waner667/esp32-c6-gimbal-tracker/mw_360base_author.png

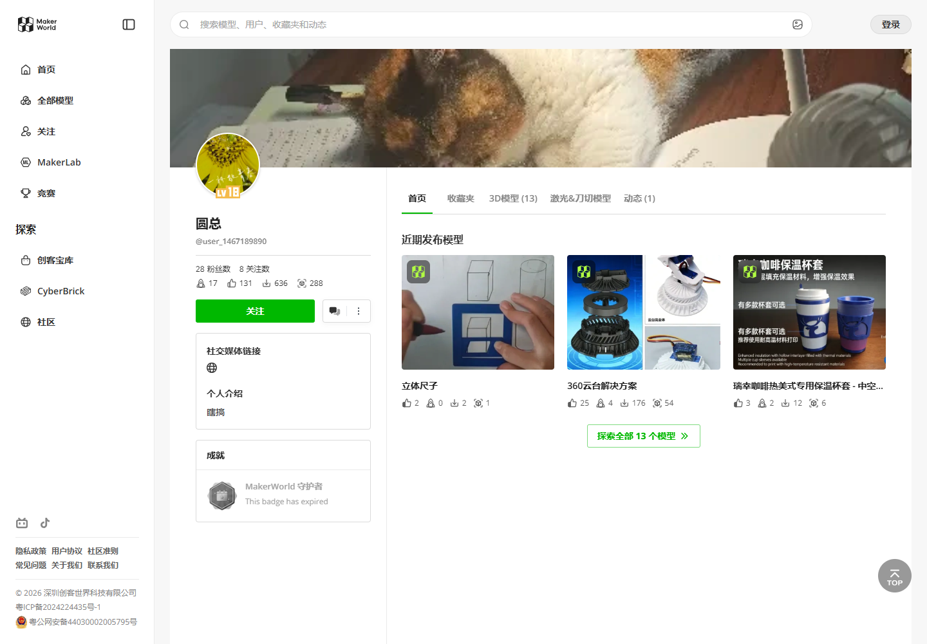
mw_360base_author.png
