waner667/esp32-c6-gimbal-tracker/mw_360base_page.png

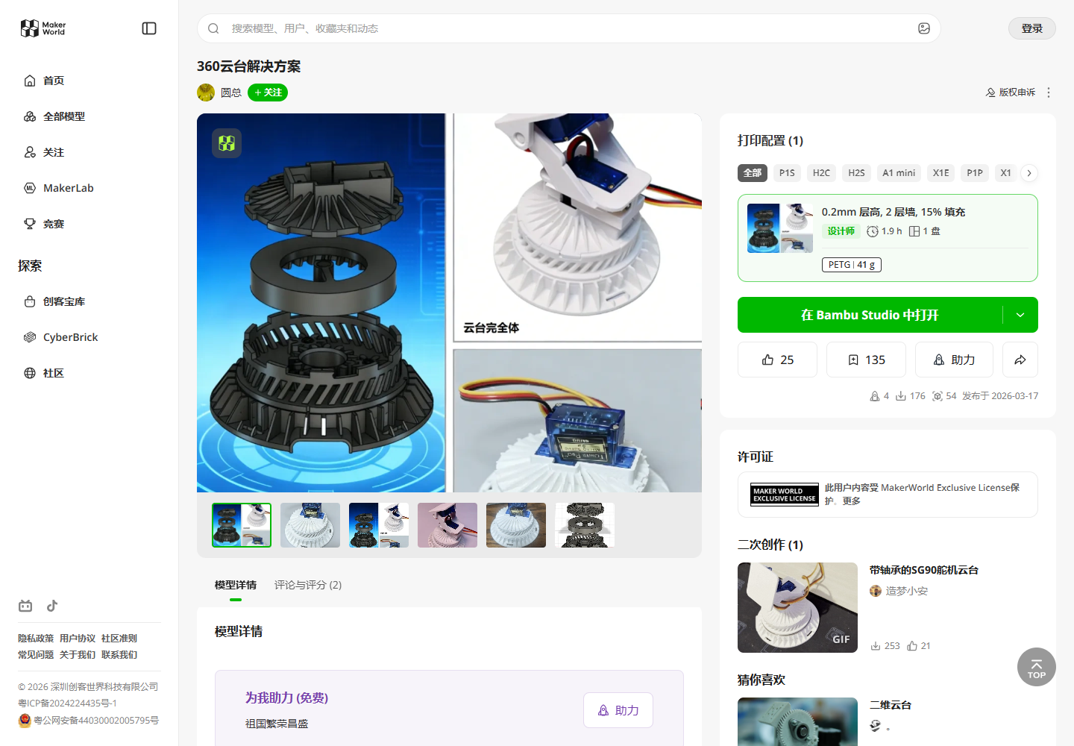
mw_360base_page.png
