waner667/esp32-c6-gimbal-tracker/servo-status.md

# 舵机线状态总览（2026-10-20 18:00 收尾）

> 本文是舵机这条线的"存档点"：做到哪了、卡在哪、怎么恢复、踩过什么坑，都在这一页。
> 实时细节以 `gimbal_firmware.ino` / `wiring-guide.md` 为准；本文管状态和历史。

---

## 一句话状态

**固件侧 100% 全通（全部实测过），硬件侧唯一卡点是降压模块烧毁。**
换一个能输出 5.0V 的电源，按第 3 节 checklist 走，10 分钟收尾。

---

## 1. ✅ 已验证 OK 的（都是实测，不是推断）

| 项 | 证据 |
|---|---|
| Arduino 环境 | esp32 core 3.3.12 + ESP32Servo 装好，编译/烧录/串口全通 |
| 固件烧录 | RST 后串口打印 `READY pan=GPIO10 tilt=GPIO11 attach=0,0` |
| PWM 挂载 | `attach=0,0` → ESP32Servo 正常挂上 LEDC 通道，PWM 确实从 GPIO10/11 输出 |
| 命令链路 | 发 `P120,T90` → 回显 `OK pan=120 tilt=90`（回显是这次专门加的，之前是哑巴） |
| 舵机本体 | 3.3V 排针碰一下橙线，舵机猛转 → SG90 是好的 |
| 供电 | 万用表测舵机红↔棕 ≈5V ✓（模块烧毁前测的） |
| 共地 | 蜂鸣档测 C6 GND ↔ 舵机 GND，通 ✓ |
| 固件功能 | 软件限位（pan 10~170 / tilt 20~110）、平滑插值（1.5°/步）、上电归中都在 |
| 遥控协议 | 三协议自动识别代码就绪（i-BUS/CRSF/SBUS @ GPIO6），**待通电后实测 `RC LOCK`** |

## 2. 🔴 当前唯一卡点：降压模块烧毁（16:55 事故）

- **经过**：12V 可调电源电压开得太大，超过降压模块输入额定，模块烧毁
- **影响**：舵机失去 5V 动力电源（信号、共地、C6 都好的）
- **C6 无损**：C6 与降压模块世界之间只连了一根共地线，没有 12V 倒灌路径；USB 一度无响应是线缆接触问题，换线后恢复
- **恢复供电三选一**：
  1. 修/换降压模块（⚠️ 可调电源**先拧回 12V** 再接模块，这次烧就是输入超额定）
  2. 手机 5V 充电头（5V/1A 以上）直供，调试完全够用
  3. 任何稳压 5V 电源

## 3. 恢复运行 Checklist（电源就绪后照做，约 10 分钟）

1. **先测压**：万用表直流档测新电源输出 = **准 5.0V**，才准碰舵机红线
2. **接线**（详见 `wiring-guide.md`）：
   - 舵机红线 → 5V+，棕线 → GND
   - **共地**：电源 GND → C6 的 GND 排针（唯一不能省的线）
   - 橙线：pan → **GPIO10**，tilt → **GPIO11**
3. C6 插 USB（USB-to-UART 那个口），串口发 `P120,T90`
4. 判读：

| 现象 | 结论 |
|---|---|
| pan 平滑转到 120° | 🎉 收工，接 tilt 双轴联调 |
| 不动 | 橙线直碰 C6 的 GPIO10 排针（绕过面包板）：转=面包板孔虚/线断；不转=告诉我，手写 LEDC PWM 替换 ESP32Servo |

## 4. 排障时间线（今天真实走过的路，含教训）

| 时间 | 事件 | 教训 |
|---|---|---|
| 早 | 回显 `pan=0 tilt=1079900208` | `panTgt/tiltTgt` 声明成 float 却用 `%d` 打印，C6 是 RISC-V 架构，float 参数进浮点寄存器，`%d` 读到残留乱值 → 角度本来就是整数，目标值用 `int` |
| 11:19 | **舵机不动破案**：pan 橙线一直插在 **GPIO13**（C6 原生 USB 的 DM/DP 数据脚），固件从 GPIO10 输出，信号断在中间 | **固件回显全正常 ≠ 线接对了**。这是今天最大的坑，极具伪装性 |
| 11:21 | 面包板只剩一列（4/5/6/7/8/10/11/12/13/1），线序定案 **GPIO10(pan)/GPIO11(tilt)** | 4/5/8/9/15 是 strapping 脚、12/13 是 USB 脚、1 是晶振脚，都碰不得 |
| 16:14~16:31 | 万用表两测（5V ✓、共地 ✓）→ 3.3V 触碰（舵机本体好）→ attach=0,0（软件全清） | 隔离法逐层排除，每一步都有明确判据，不猜 |
| 16:55 | **降压模块烧毁** | 可调电源先调压再接负载；调压用万用表，不信目测 |
| 18:06 | （摄像头线）按 0 切内置摄像头画面冻住，已修 `camera_test.py` | 切换采集设备先 release 旧的，否则双设备抢占把 `read()` 阻塞死 |

## 5. 防呆要点（血泪浓缩）

1. **固件回显全正常 ≠ 硬件接对**——GPIO13 案例：软件说 `OK pan=120` 说得漂漂亮亮，信号压根没出 C6
2. **12V 可调电源：先调压，后接线**——这次模块就是这么烧的
3. **GPIO12/13 是 USB 数据脚，任何线不往上插**；4/5/8/9/15 是 strapping 脚，接了可能开不了机
4. **共地是唯一不能省的线**，漏了它舵机完全不理会你
5. **万用表三步走**（舵机不动时）：红↔棕 5V → 蜂鸣档共地 → 橙↔棕发命令有跳动，比肉眼排查十圈都快

## 6. 文件索引

| 文件 | 内容 |
|---|---|
| `gimbal_firmware/gimbal_firmware.ino` | 固件，PAN=GPIO10 / TILT=GPIO11，遥控 RX=GPIO6，带回显和 attach 状态 |
| `wiring-guide.md` | 施工级接线文档（总览图/6 步顺序/故障速查/遥控协议对照） |
| `gimbal_firmware/servo_test.py` | PC 端测试脚本，`python servo_test.py COM10` |
| `tracker.py` | 闭环追踪（`--port COM10`），电源恢复后直接跑它看追人 |
| `README.md` | 项目总索引（状态/文档分工/运行方式） |
| `gimbal-plan.md` 第 11 节 | 项目总 checkpoint |
| `.workbuddy/memory/2026-10-20.md` | 当天完整流水日志 |
