waner667/esp32-c6-gimbal-tracker/docs/architecture-closed-loop.png

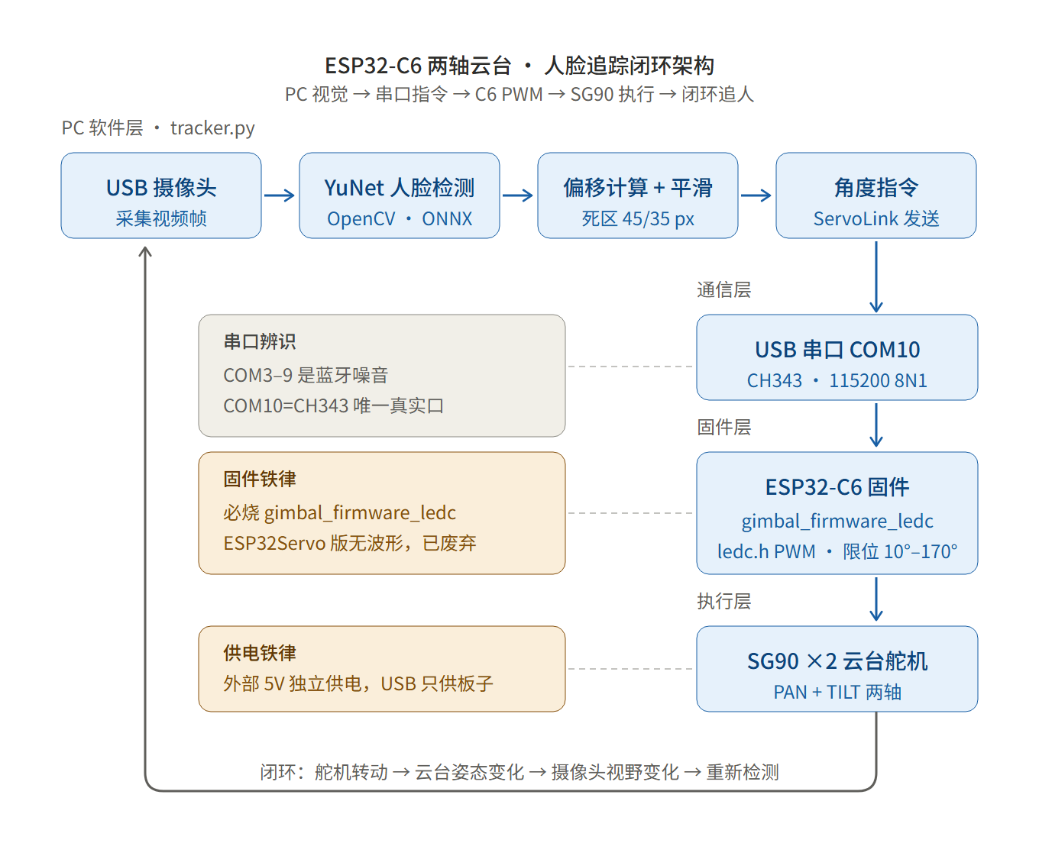
docs/architecture-closed-loop.png
