waner667/esp32-c6-gimbal-tracker/docs/pc-software-toolchain.png

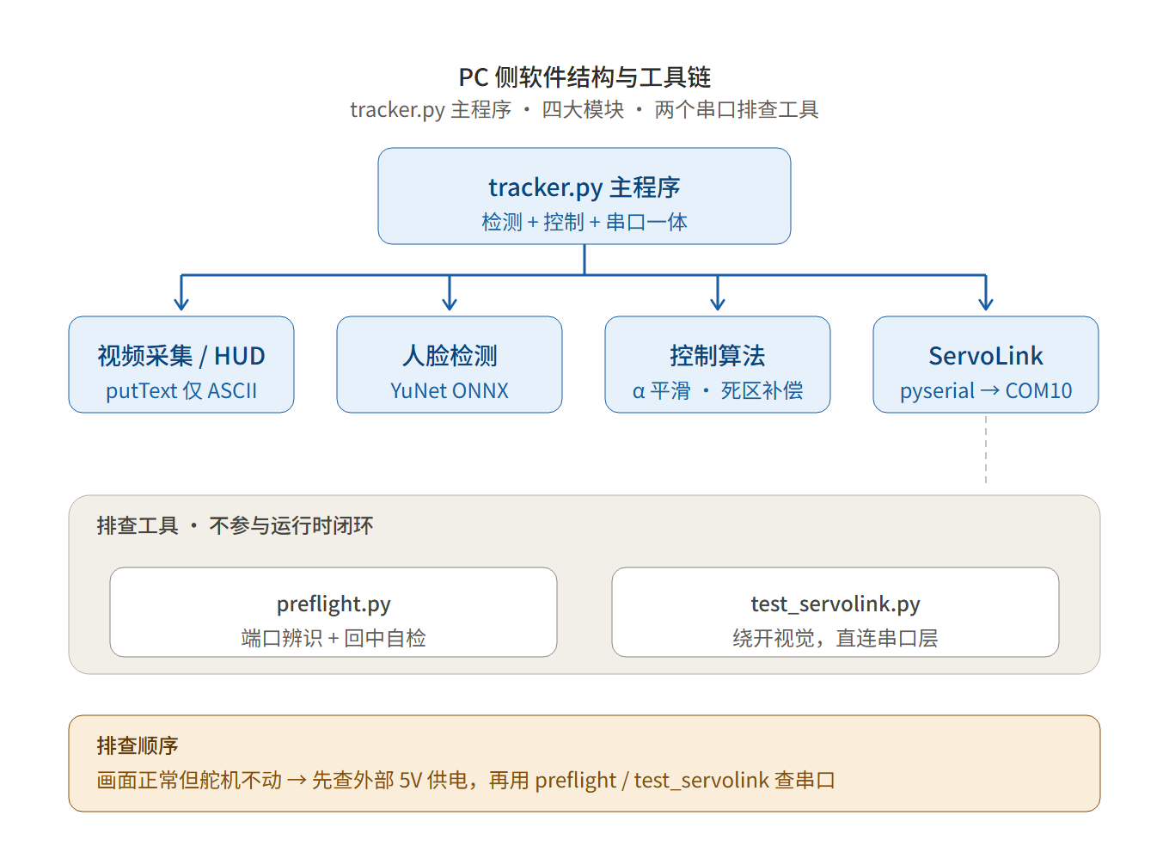
docs/pc-software-toolchain.png
