waner667/esp32-c6-gimbal-tracker/face_snapshot.png

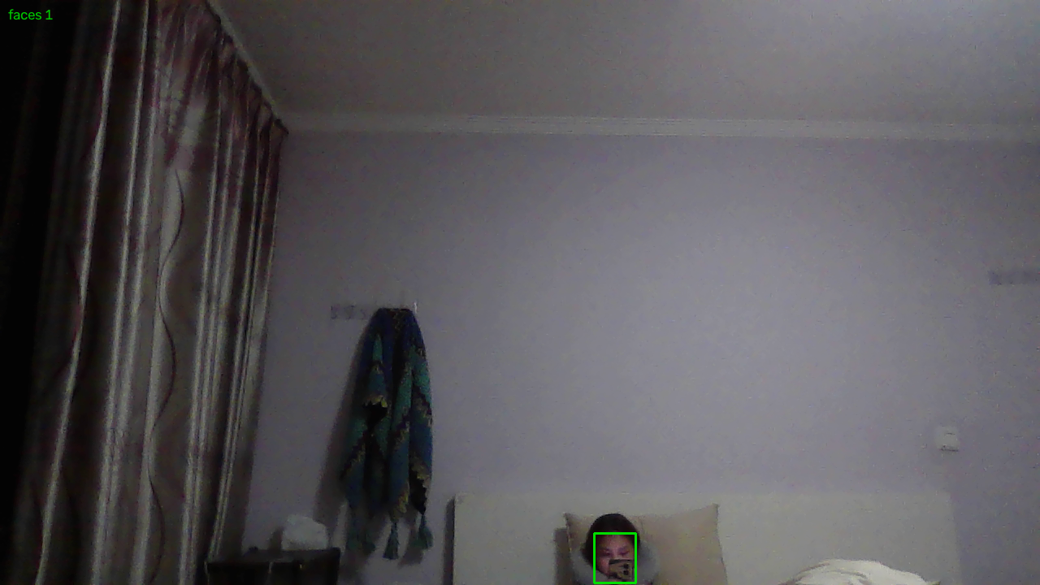
face_snapshot.png
