waner667/esp32-c6-gimbal-tracker/snapshot.png

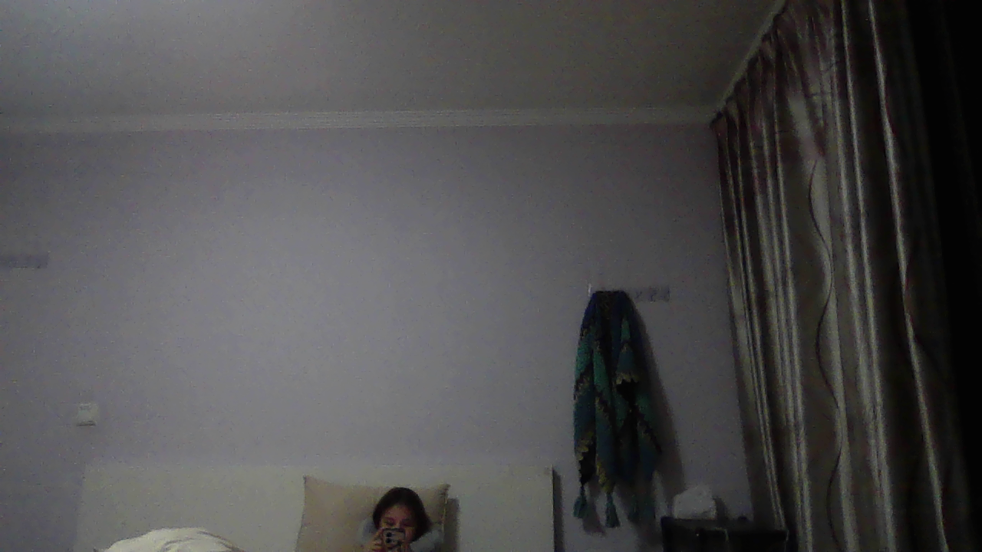
snapshot.png
