waner667/esp32-c6-gimbal-tracker/wiring-guide.md

# 云台接线指南（路线 A · 面包板点亮）

> 目标：ESP32-C6 + 1~2 个 SG90 舵机，串口/遥控双通道可控。本文是**施工级**文档，每根线的去向都说死。
> 对应规划：`gimbal-plan.md` 第 5 节。引脚：**GPIO10 = pan（底座舵机）、GPIO11 = tilt（顶部舵机）、GPIO6 = 遥控接收机信号**。

---

## 0. 物料核对

| 物料 | 本次是否必需 | 备注 |
|---|---|---|
| ESP32-C6 DevKitC-1 | ✅ | USB-to-UART 口接电脑（不是原生 USB 口） |
| SG90 舵机 ×1~2 | ✅ | 先接 1 个（pan）点亮，第二个后接 |
| 12V 可调电源 | ✅ | 给降压模块供电 |
| 降压模块（可调 DC-DC） | ✅ | 输出调到 **5.0V**，给舵机专用 |
| 面包板 + 杜邦线 公对母 | ✅ | |
| 万用表 | ✅ | 调压必须，不接受目测 |
| USB 线（C6 to 电脑） | ✅ | C6 的供电 + 数据都靠它 |
| 遥控接收机（A8S / ELRS RX） | ⬜ 可选 | 信号单线接 C6 GPIO6，见第 6 节 |

---

## 1. 系统总览（一图流）

```
┌──────────────┐
│  12V 可调电源 │
└──┬─────────┬──┘
  (+)       (-)
   │         │
   ▼         ▼
┌──────────────┐
│   降压模块    │  ← 万用表测输出，调准 5.0V
└──┬─────────┬──┘
  (+)       (-)  ← 舵机专属 5V 电源
   │         │
   │    ┌────┴────┐
   │    │         │
   ▼    ▼         ▼
 ┌──────────────┐  ┌──────────────┐
 │  SG90 #1 pan │  │  SG90 #2 tilt│
 │ 红(+) 棕(-) 橙│  │ 红(+) 棕(-) 橙│
 └──┬────┬────┬─┘  └──┬────┬────┬─┘
    │    │    │       │    │    │
    │    │    └───────┼────┼──────┐
    │    │            │    │      │
    │    │  ┌─────────┘    │      │
    │    │  │   ┌──────────┘      │
    │    │  │   │                 │
    │    │  │   │          (橙线)(橙线) │
    │    │  │   │                 │      │
    │    │  │   ▼                 ▼      │
    │    │  │ GPIO10         GPIO11     │
    │    │  │  ┌───────────────────┐     │
    │    │  │  │    ESP32-C6       │     │
    │    │  │  │              GND ├─────┘
    │    │  │  │           USB口 ├───────→ 电脑
    │    │  │  └───────────────────┘
    │    │  │
    └────┴──┴── 舵机电源正/负在降压模块侧并联

┌──────────────┐
│ 遥控接收机    │  A8S(i-BUS/SBUS) 或 ELRS RX(CRSF)
└──┬─────┬────┘
 信号(+)5V  GND │
   │      │    │
   │      └────┼──────────────→ 降压模块 OUT-（共地）
   │           │
   ▼           ▼
 GPIO6      （5V 调试期可吃 C6 的 5V 排针，接收机电流 <100mA）
```

---

## 2. 分步接线（按这个顺序做）

### 第 1 步：降压模块调压（舵机先不接）

- 12V 电源 → 降压模块 `IN+ / IN-`
- **万用表直流档测 `OUT+ / OUT-`**，拧电位器调到 **准 5.0V**
- 🔴 **红线：没测准之前，舵机线碰都别碰。12V 直冲 SG90 瞬间烧毁。**
- 调好后 12V 电源保持通电（输出电压稳定）

### 第 2 步：舵机电源并联

| 从 | 到 |
|---|---|
| 降压模块 `OUT+` | 两个舵机**红线**（+） |
| 降压模块 `OUT-` | 两个舵机**棕/黑线**（-） |

只接 1 个舵机就只接一组。并联 = 都插降压模块输出这一侧（或面包板同一条电源轨）。

### 第 3 步：信号线（橙/黄）

| 舵机 | 信号线 | 到 C6 |
|---|---|---|
| pan（底座） | 橙 | **GPIO10** |
| tilt（顶部） | 橙 | **GPIO11** |

> 🔴 **这列上能用的信号脚只有 GPIO10 / GPIO11（相邻，pan/tilt 并排插）。**
> - **GPIO4 / 5 / 8 / 9 / 15 是 strapping 脚**：上电电平决定启动模式，接舵机可能导致无法启动。
> - **GPIO12 / 13 是 C6 原生 USB 的 DM/DP 数据脚，任何线都不要往上插**——2026-10-20 实际翻过车：pan 信号线插在 GPIO13，固件从另一个脚输出，舵机全程收不到信号，而固件回显一切正常，极具伪装性。
> - GPIO1 大概率被 32K 晶振占用。
>
> 插线后默念：**底座→10，顶部→11，strapping/USB 脚不碰。**

### 第 4 步：共地（唯一连接两个"电源世界"的线）

| 从 | 到 |
|---|---|
| 降压模块 `OUT-`（舵机电源地） | **C6 的 GND 排针** |

一根杜邦线。**这是整个接线里唯一不能省的线**——不接，PWM 信号没有共同参考电平，舵机表现为完全不理会你或随机抽搐。

### 第 5 步：USB

C6 的 **USB-to-UART 口**（带桥接芯片的那个 Type-C）→ 电脑。C6 的供电、数据、地和电脑都在这一根线里，**C6 不需要任何其它供电**。

### 第 6 步：遥控接收机（可选，GPIO6）

| 接收机线 | 到哪 | 说明 |
|---|---|---|
| 信号线（i-BUS/SBUS/CRSF 单线输出） | **C6 GPIO6** | 三协议固件自动识别 |
| 接收机 VCC（+） | 降压模块 OUT+ 或 **C6 的 5V 排针**（调试期） | 接收机电流 <100mA，C6 5V 排针带得动 |
| 接收机 GND | 降压模块 OUT- / C6 GND（共地） | 不共地遥控收不到 |

**协议对照**（固件三协议全支持，接错线也不用换固件）：

| 遥控器 | 接收机 | 输出协议 | 波特率 | 反相 | 备注 |
|---|---|---|---|---|---|
| FS-i6X | FlySky A8S | **i-BUS** | 115200 | 否 | A8S 用绑定键切到 i-BUS 模式 |
| FS-i6X | FlySky A8S | SBUS | 100000 | **是** | C6 的 UART 有硬件反相寄存器，固件里打开，**不用外接三极管** |
| LiteRadio 2 SE | ELRS RX | **CRSF** | 420000 | 否 | ELRS 默认 CRSF；要 SBUS 需在 ELRS 配置里改 |

> 串口命令：`RC=i|c|s` 手动锁定协议；`RC` 查当前状态；`RCV` 打印 16 个通道原始值（对摇杆通道用）。
> 固件启动时会打印 `RC LOCK i-BUS` / `RC LOCK CRSF` 表示认到了哪种协议。

---

## 3. 上电顺序与验收

1. ✅ 降压模块输出 = 5.0V（万用表复测）
2. ✅ 舵机红/棕已接、信号线已接、共地已接
3. C6 插 USB
4. 烧录固件（Arduino IDE → ESP32C6 Dev Module），串口监视器 115200
5. 看到 `READY` → 两个舵机应已**归中到 90°**
6. 串口发 `P120,T90` → pan 转；`P90,T60` → tilt 转
7. 或跑 `python gimbal_firmware/servo_test.py COM3`，输入 `90 45` 控角
8. （接了遥控）遥控器开机，启动行出现 `RC LOCK xxx` → 拨右手柄（ch1 左右 / ch2 上下）云台跟着转；串口发 `P120,T90` 抢回 USB 控制，打印 `MODE=USB`

---

## 4. 故障速查（按现象查）

| 现象 | 头号嫌疑 | 排查 |
|---|---|---|
| 舵机完全不动、无任何声音 | **没共地** | 查第 4 步那根线，舵机电源 GND ↔ C6 GND |
| 舵机完全不动 | 信号线插错脚 | 固件是 GPIO10/GPIO11，对照第 3 步；重点看是不是插到了 strapping 脚或 **GPIO12/13**（USB 数据脚，2026-10-20 实际翻车点） |
| 舵机"嗡嗡"响但不动 / 抖动 | 供电不足或纹波 | 降压模块电流余量；输出端并一颗 **470µF 电解电容**（规划第 5 节） |
| C6 反复重启、串口乱码 | 舵机从 C6 取电/USB 带不动 | 舵机电源只认降压模块，**绝不接 C6 的 5V 排针** |
| 舵机不转、只是慢/抖/挂载后滑落 | **供电只有 3.3V** | SG90 datasheet 标 3.0~7.2V，3.3V「能转」但扭矩和保持力大幅下降。舵机电源必须 5V；信号 3.3V 是对的，不用改也不用电平转换 |
| 回显 `OK pan=120` 但舵机完全不转（attach=1,1 正常） | **ESP32Servo 在 C6 上 attach 成功但无波形** | C6 的 LEDC **只有 LOW_SPEED_MODE**（无高速模式），库默认配置对不上 → 换 `gimbal_firmware_ledc/gimbal_firmware_ledc.ino`（底层 `driver/ledc.h`），串口发 `PWM` 读回平均电压自检 |
| 一上电舵机狂转不停 | 信号线松了/碰到 GND | 重插橙线 |
| 转到的方向是反的（该 pan 时 tilt 动） | 两个橙线插反 | 对调即可，或发命令时 P/T 数值对调 |
| 遥控没反应、串口没有 `RC LOCK` | 协议没对上/没共地 | ① 万用表测接收机 GND ↔ C6 GND 通不通；② 发 `RCV` 看有没有通道值跳；③ `RC=i`/`RC=c`/`RC=s` 手动锁定逐个试 |
| 遥控模式下云台自己缓慢漂移 | 摇杆没回中/中位不准 | 遥控器里看该通道中位是否 1500；或在遥控器通道设置里微调中位 |
| 串口没 `READY` | 开发板选错/端口选错 | Arduino IDE 选 ESP32C6 Dev Module；端口按设备管理器 |

---

## 5. 绝不再问的四句话

1. **C6 只接四样**：USB（电脑）、GPIO10/11（舵机信号）、GPIO6（遥控信号，可选）、GND（共地）。不接电源。
2. **舵机三根全接**：红线→降压 5V，棕线→降压 GND，橙线→GPIO10/11。电全来自降压模块。
3. **遥控接收机三根**：信号→GPIO6，VCC→5V（调试期可借 C6 的 5V 排针），GND→共地。i-BUS/CRSF/SBUS 固件都认，SBUS 反相在芯片里解决，不用外接电路。
4. **降压模块不调准 5.0V，不碰舵机红线。**

## 6. 绝不再问的第五句话：电压分工

| | 电压 | 谁提供 |
|---|---|---|
| 舵机电源（红/棕） | **5.0V** | 降压模块，绝不接 C6 的 3.3V/5V 排针 |
| 舵机信号（橙） | **3.3V PWM** | C6 GPIO10/11，**不用改也不用加电平转换** |

**为什么 3.3V 信号能驱动 5V 舵机**：舵机内部用比较器判 PWM 高低电平，阈值约为自身供电的一半（5V 时 ≈2.5V）。C6 输出的 3.3V 高电平稳稳越过阈值，这是标准做法。

**3.3V 当舵机电源会怎样**：SG90 datasheet 标 3.0~7.2V，所以 3.3V 能点亮能转，但扭矩/保持力大幅下降——表现为转动慢、挂上摄像头后抖、慢慢滑落。**「能转」不等于「能用」。**

## 7. 机械装配与零位对正（装结构件前必读）

### 7.1 固件里的 90° 是什么

固件角度 = 舵机脉宽，`angleToUs(a) = 1000 + a/180×1000`：

| 固件值 | 脉宽 | duty(16bit) | 云台姿态 |
|---|---|---|---|
| pan = 90 | 1500us | 4915 | **U 型框开口朝向「正前方」**（设计基准方向） |
| tilt = 90 | 1500us | 4915 | **摄像头镜头水平朝前，不俯不仰** |
| pan = 10 / 170 | 1056 / 1944us | 3460 / 6370 | 左右各约 80°（防 USB 线绞） |
| tilt = 20 / 110 | 1111 / 1611us | 3640 / 5279 | 俯 / 仰（tilt 量程比 pan 窄，机械扫掠定案） |

发 `H` = 两路同时给 1500us 中位脉宽。**固件上电时也会先自动归中到 90°。**

### 7.2 装配顺序（顺序反了会别坏打印件）

1. **先通电归中**：发 `H`，等两个舵机稳稳停在中位（不再动）
2. **再装结构件**：pan 舵机臂 + U 型框，让 U 型框开口朝向正前方；tilt 舵机臂 + 摄像头夹，让镜头水平
3. **拧紧中心固定螺丝**（SG90 自带那颗，锁舵机臂于花键轴）
4. **验证行程**：`P10` → `P170` 左右到头；`T20` → `T110` 俯仰到头

⚠️ **为什么必须先归中再装**：舵机每次上电都会先猛甩到 90° 再听命令。断电时随便装结构件，上电瞬间它会带着结构件甩到中位——轻则打偏，重则别坏打印件、把舵机臂齿打滑。

### 7.3 舵机臂选型（scad 接口决定，别装错）

| 轴 | scad 接口 | 用哪种臂 | 固定方式 |
|---|---|---|---|
| **pan** | 底盘 **2 个对角孔**，半径 `horn_arm_r=13mm`，角度 **45° / 225°** | **双臂臂**（两臂尖距 26mm） | 两个臂尖分别插进两个孔 |
| **tilt** | 插座**臂槽**宽 `horn_arm_w+0.6=5.6mm`，只容单臂 | **单臂** | 臂插入臂槽 + 一颗 **M2 自攻**横穿（对正 `r=13`） |

⚠️ **pan 用单臂 = 装不出稳定结构**：只能插一个孔，会绕轴空转、晃动，扛不住「U 型框 + tilt 舵机 + 摄像头」的悬臂负载。SG90 包装里通常同时带单臂和双臂，把双臂找出来。

### 7.4 中位对不准怎么办

装好后发 `P90,T90`，如果云台偏了一个角度：

- 偏差 **<20°**：舵机臂在花键轴上换一个齿位重新啮合（SG90 花键约 21~25 齿，每齿 14~17°），再装
- 偏差 **很大或装不上**：舵机臂方向装反了，拔下来转 180° 重装
- **tilt 方向反了**（发 `T110` 摄像头反而低头）：舵机横装时装反了，把 tilt 舵机转 180° 重装；或在 `tracker.py` 里加 `--invert-tilt`
- **pan 方向反了**：同理，`tracker.py` 加 `--invert-pan`

### 7.4 不依赖角度的实操判据

记不住角度就看姿态，只看两条：

- **pan 中位** = 你坐在电脑前，摄像头（U 型框开口）正对着你的脸
- **tilt 中位** = 摄像头镜头水平，既没朝天也没朝地

这两条对了，`H` 就是「回正」，追人时人脸会稳定落在画面中心。
