waner667/esp32-c6-gimbal-tracker/open-issues.md

# 云台项目 · 未解决问题清单

> 整理时间：2026-10-22 21:50（waner 正在 3D 打印结构件）
> 用途：打印等待期间的问题总账。分四档，按紧急程度从上往下。

---

## 🔴 第 0 档：现成模型 vs 自研模型 —— 先决策再打（2026-10-22 新增）

waner 提出 MakerWorld 模型「360云台解决方案」（`makerworld.com.cn/zh/models/2274032`，作者**圆总** `/zh/@user_1467189890`），并明确偏好：**「以后模型我们能用现成的就用现成的」**。

### 该模型实测信息

| 项 | 值 |
|---|---|
| 内容 | 行星齿轮 **2:1** 减速，让 180° SG90 达到 360° 旋转，**仅云台底座** |
| 打印 | 0.2mm 层高 / 2 层墙 / **15% 填充** / PETG / 41g / 1.9h |
| 数据 | 下载 25 / 点赞 135 / 收藏 176 / 评论 54，发布 2026-03-17 |
| 许可 | MakerWorld Exclusive License |
| 装配注意 | 结构中部分可用耗材插销；行星齿轮转轴处需打磨减小摩擦 |

### 三个硬问题（不建议直接采用）

1. **没有配套上部结构**。作者描述说"云台上部结构可以从我的其他作品中下载"，但圆总主页**全部作品只有 3 个**：立体尺子、本底座、瑞幸保温杯套。**上部结构不存在**——拿到底座也组不出完整云台。
2. **360° pan 与 USB 摄像头直接冲突**。本项目摄像头是有线 USB（含线 38g），`gimbal-plan.md` 明确记录绞线风险，对策就是"pan 限 ±90°、走线孔、留余量"。360° 底座会让 USB 线绞死，除非换无线图传或加滑环。
3. **2:1 增速带来三重代价**：扭矩减半（SG90 1.8→0.9 kg·cm，还要扛 U 框+tilt+摄像头）、回差放大 2 倍、**固件角度映射全变**（云台角 = 2×舵机角 − 90，pan 限位 10~170 和 `tracker.py` 的 `kx/ky` 增益全部要重新标定）。

### 结论与建议（⚠️ 2026-10-24 已推翻，见下一档）

> ~~**继续用自研 `gimbal.scad`**~~ —— **已作废**。2026-10-24 waner 换用**同作者的另一个模型** `#2045352「Sg90舵机云台修改（仰角限位以及底座）」`，摄像头已固定、云台已组装。自研 `gimbal.scad` 的三个估测值（`lens_z_off` / `led_h` / `usb_dir`）**不再需要核对**，cradle 也不用重打了。

「能用现成的就用现成的」原则在这个项目的最终落地：
- **整体结构**：现成的 #2045352（底座 + U 框 + 抬高限位 + 电缆导线槽，一次到位）
- **摄像头夹**：waner 自行适配固定（现成模型都是红外/通用接口，不配套 USB 摄像头）
- **下一个硬件项目**：第一步先搜 MakerWorld / Printables，有合适的就不再自己画

---

## 🔴 第 -1 档：现用模型 #2045352 装配与标定（2026-10-24 新增，最高优先）

| 项 | 值 |
|---|---|
| 模型 | `makerworld.com.cn/zh/models/2045352-sg90duo-ji-yun-tai-xiu-gai-yang-jiao-xian-wei-yi-j` |
| 作者 | **圆总**（与 360 底座同一人 `/zh/@user_1467189890`），改版自 lilithlying 的 SG90 2 向云台 |
| 打印 | 0.2mm / 2 墙 / 15% 填充 / PETG / **22g / 1.3h / 1 盘**｜发布 2026-01-22 |
| 许可 | Standard Digital File License |

**作者的三处改进，正好命中本项目需求**：
1. **释放约 45° 仰角** —— 原型俯仰角度受限（原设计用途是机房空调红外控制，打不到高处）；改进后 tilt 上仰行程大增
2. **底座延伸** —— 可稳固安装，waner 实测已站稳
3. **电缆导线槽** —— 底座左右两侧各有线槽，两个舵机的线集中走槽，**直接解决此前担心的 pan 绞线与走线凌乱**

### ⚠️ 作者唯一的硬警告（装配时必须核对）

> **下方舵机采用「插入」的方式安装；如果用「夹入」的方式，会影响上方舵机的仰角。**

pan 舵机必须**插进底座的槽/孔**里，不能只用侧壁夹住。夹入会让 pan 舵机位置偏移，直接吃掉 tilt 的仰角行程——而仰角正是这个模型的核心改进。
**核对办法**：不通电，用手把 tilt 推到最上仰，看能不能顶到设计的最高位；如果明显顶不到，就是 pan 舵机装法错了，拆下来重插。

### 换模型后固件要不要改？

| 项 | 结论 |
|---|---|
| 角度映射（舵机角 = 云台角，一一对应） | ✅ **不用改**。直驱无齿轮，`P90/T90` 就是机械中位 |
| `PAN_MIN/MAX = 10/170` | ✅ 可用。SG90 本身 180° 行程，留 10° 余量防撞 |
| `TILT_MIN/MAX` | ✅ **已改为 10/170**（2026-10-24）。实测结构无死挡位，约束在舵机内部；原 20/110 是自研 scad 旧值 |
| 引脚 GPIO10/11、`tracker.py` 增益 | ✅ 不变 |

**实测 tilt 机械限位**（✅ 已完成 2026-10-24）：waner 不通电手推全程，**无明显结构死挡位，行程约 180°** → 约束来自 SG90 内部行程而非结构件，「抬高限位」改进真实可用。
**结论**：限位按舵机安全行程设，与 pan 对齐 —— 固件已改为 `TILT_MIN=10 / TILT_MAX=170`（原 20/110 是自研 scad 的旧值，那版 tilt 上仰被结构吃到只有 20°）。两端各留 10° 防舵机顶内部死点。

---

## 🟢 第 -2 档：tracker 串口不通 —— 云台不追人（✅ 2026-10-24 上午已结案）

**现象**（2026-10-24 01:20 复现）：摄像头窗口正常、绿框跟着脸走、HUD 的 dx/dy 在变，**但云台不动**。

### 结案结论：串口链路已全线打通

用新建的 `preflight.py` 一键自检，实测通过：

| 检查项 | 结果 |
|---|---|
| 真实端口 | **COM10**（CH343，`USB VID:PID=1A86:55D3`）—— 本机唯一真实 USB 串口；其余 6 个全是蓝牙串口噪音（hwid 含 `BTHENUM`，设备没连，开口就报「信号灯超时」，纯噪音） |
| 板子识别 | DTR/RTS 手动复位脉冲诱出完整启动行：`BOOT LEDC 版` / `pan gpio=10 OK` / `tilt gpio=11 OK` / `READY … limit=10..170/10..170` |
| 双向链路 | 发 `PWM` 双通道回显：`pan gpio=10 us=1500 duty=4915 pct=7.5% (avg 0.247V)`，tilt 同 |
| PWM 电压 | 0.247V ≈ 期望 0.248V，波形是真的 |

**昨晚失败的真正原因**（三个嫌疑的最终裁决）：

| # | 原嫌疑 | 裁决 |
|---|---|---|
| 1 | COM 口号不对 | ❌ **排除**。portdump 证明 COM10 就是唯一真实 USB 串口，口号本来就是对的 |
| 2 | 串口监视器占着口 | ⚠️ **部分成立**。昨晚 tracker 跑起来时 COM10 打不开（降级仅检测）；今天排查时 COM10 一度「拒绝访问」，但**进程表里根本没有占用方**（无 Arduino IDE、无 java、只有一个昨天下午启动的 python）→ 判定为 USB 重新枚举后的**僵尸句柄/端口卡死**，后来自己释放了 |
| 3 | python 解释器缺 pyserial | ❌ **排除**。受管解释器 `pyserial 3.5` 在位 |

**放大伤害的是那个 HUD bug**：连接失败也显示端口名，看起来像连上了——所以「云台不动」看起来像灵异事件。已修（见文末表）。

**最终根因（2026-10-24 12:09 waner 自查确认）：外部 5V 电源没开。** 板子由 USB 供电，串口/固件一切正常（所以回显全 OK、preflight 预检全绿），但 SG90 的 5V 供电是独立的——没上电时现象就是「命令发着、回显 OK、舵机不动」。**教训：① 预检绿灯 ≠ 舵机能转，舵机动作必须外部 5V；② 「回显正常但不执行」先查供电再查代码；③ preflight 只验信号链路，测不出供电问题。**

### 判据：两个地方一看就知道哪环断了（保留备用，以后再出问题还用这个）

**① HUD 左下角 `servo` 那一行**（已修复，原来这里显示端口名、连接失败也照样显示，极具误导性）：

| 显示 | 含义 |
|---|---|
| `servo OFF` | 没给 `--port`，压根没建链路 |
| `servo COM10·未连上` | 建了对象但**没连上**（端口打不开 / pyserial 缺失） |
| `servo COM10` | 连上了，命令在发 |

**② PowerShell 控制台启动那几行**：

| 打印 | 含义 |
|---|---|
| `[串口] 已连接 COM10 @ 115200` | 连上了；此时应伴随 `[C6] OK pan=.. tilt=..` 回显 |
| `[串口] 连接 COM10 失败：<原因>（继续仅检测模式，按 c 重试）` | 端口打不开 |
| `[串口] pyserial 未安装，降级为仅检测模式` | python 解释器用错了 |

### 现在直接跑这条（已带真实端口 COM10）

```powershell
& "C:\Users\a\.workbuddy\binaries\python\versions\3.13.12\python.exe" "E:\QRS\Project\3esp32_云台_摄像头\tracker.py" --port COM10
```

成功的标志：HUD 显示 `servo COM10`（不带「未连上」）+ 控制台刷 `[C6] OK pan=.. tilt=..`。
任何时候串口再犯邪，先跑 `preflight.py` 自检（上面那张表的来源），它会直接告诉你端口/占用/链路三件事。

### 本轮修掉的三个真 bug + 一个新工具

| 文件 | 问题 | 修法 |
|---|---|---|
| `tracker.py` HUD | 连接失败时 `servo` 仍显示端口名，看起来像连上了——**这就是这次难定位的直接原因** | 改成连接失败时显示 `COM10·未连上` |
| `tracker.py` 第 43 行 | `TILT_MIN, TILT_MAX = 20, 110` 还是旧值，和固件新的 10/170 不一致，tracker 永远用不上新放的仰角 | 同步为 `10, 170` |
| `preflight.py`（新建） | 第一版只被动读启动行——**开端口不会让 C6 复位**，永远认不出板子；还把蓝牙口的「信号灯超时」误报成「被 Arduino IDE 占着」 | 重写：DTR/RTS 手动复位脉冲诱启动行 + **主动发 `PWM` 诱出回显**（认板硬判据）+ 按 hwid 标注蓝牙噪音 + 打不开时给「关串口工具→拔插 USB」处置顺序 |

---

## 🔴 第一档：打印前/打印中必须核对（⚠️ 已作废 —— 2026-10-24 换用现成模型 #2045352，`gimbal.scad` 不再打印，三个估测值无需核对。以下仅为存档。）

`gimbal.scad` 顶部有三个**估测值**，其中两个直接决定打印件能不能用。拿 USB 摄像头实物，用尺子量：

| 参数 | 当前值 | scad 原文警告 | 量什么 | 量错后果 |
|---|---|---|---|---|
| `lens_z_off` | **12（估）** | "估 12；导出前核对，估错会撞筒" | PCB 竖放，量**镜头筒圆心到 PCB 长边顶端的距离**（沿板面方向） | 桥/底前唇与镜头筒避让出错，可能撞筒或余量过大 |
| `led_h` | **18（待核）** | "仍待核：量一下灯柱高度" | **LED 灯柱高出板面**多少 mm | 灯柱被结构件挡住，或避让白留一大块 |
| `usb_dir` | **""（待定）** | "若从顶边/侧边出，需在背板对应位置开出线槽" | USB 线从 PCB **哪个边**出来（底边 / 顶边 / 侧边） | 线出不来，或要重新开槽改背板 |

**已确认不用量的**（2026-10-20 waner 实测过）：
`pcb_w=19` / `pcb_h=55` / `pcb_t=1.8` / `lens_d=14.5` / `lens_h=25` —— 这些都有 ✅ 标记，别重复量。

**如果已经打了一部分**：先看 `usb_dir`——这一项如果是"顶边/侧边出线"，背板必须开槽，**正在打的 `cradle` 可能要重打**。`lens_z_off` 和 `led_h` 只影响避让余量，影响小得多。

---

## 🟡 第二档：装配待办（2026-10-24 按模型 #2045352 重写）

| # | 事项 | 状态 | 说明 |
|---|---|---|---|
| 1 | **pan 舵机必须「插入」安装** | ⏳ 待核对 | 作者硬警告：夹入会吃掉 tilt 仰角。核对法见上一档，手推 tilt 能顶到最高位即正确 |
| 2 | **两个舵机走导线槽** | ⏳ 待核对 | 底座左右两侧都有线槽，任选一侧；线集中走槽，别散在外面 |
| 3 | **实测 tilt 机械限位** | ✅ 已烧录确认 | 手推无明显结构死挡位、行程约 180°（约束在舵机内部）。固件已改 `TILT 10/170`，2026-10-24 01:10 串口确认 `limit=10..170/10..170` |
| 4 | **USB 线留松弛圈** | ⏳ 待做 | 照片里 USB 线从云台右侧水平伸出；pan 在 10~170 内转，线必须留够余量，**别让线材本身成为机械限位** |
| 5 | 摄像头 FPC 排线止点 | ⏳ 待做 | 排线短，tilt 打极限时容易折；在支架上找个点扎带固定，让弯折发生在留足的位置 |
| 6 | 方向反了怎么办 | 📖 已记录 | `tracker.py` 加 `--invert-pan` / `--invert-tilt`，不用拆 |

---

## 🟢 第三档：本轮已解决（不用再管）

| 问题 | 根因 | 解法 |
|---|---|---|
| 舵机完全不转，回显全正常 | **ESP32Servo 在 ESP32-C6 上 attach 成功但 PWM 无波形**。C6 的 LEDC 只有 `LOW_SPEED_MODE`（无高速模式），库默认配置对不上 | 新建 `gimbal_firmware_ledc/gimbal_firmware_ledc.ino`，PWM 走底层 `driver/ledc.h` 自己配 timer/channel。**已生效，舵机可动** |
| 舵机供电接 3.3V 的疑问 | 概念混淆 | 舵机电源 5V、信号 3.3V，两者不冲突；3.3V 信号驱动 5V 舵机是标准做法（阈值 ≈0.5×Vcc），不用电平转换 |
| 外部 5V 电源缺失 | 降压模块 2026-10-20 烧毁 | 12V 可调电源 + 修好的降压模块已接（先拧回 12V 再接，输出调准 5.0V） |

---

## ⚪ 第四档：装配完后

| # | 事项 | 命令/动作 |
|---|---|---|
| 1 | 全量上电验收 | `python gimbal_firmware/verify_powerup.py`（自动找板子→attach→归中→pan/tilt→极限行程→报告；LEDC 版会多跑 S1b PWM 自检） |
| 2 | 看云台追人 | `python tracker.py --port COMx`（YuNet 检测 → 比例控制 → 自动发角度） |
| 3 | 遥控接入验证 | 遥控器开机，串口应打印 `RC LOCK i-BUS`；拨右手柄 ch1/ch2 直接控 |

> 已作废：自研 `gimbal.scad` 的 STL 导出与三个估测值核对 —— 换用现成模型 #2045352 后不再需要。

---

## 附：本档之外的遗留（其他线，不挡云台）

- 资料库旧文档《Ep0 ·剪辑规划（语音助手）》`xbds6yJXe1zqKOmmRu9MA2` 需手动删（资料库无删除 API）
- `srt_ep0_keywords.srt` 未生成
- Ep0 1:40 完整版粗剪未搭（已发的 29 秒是引流片）
- 抖音第 1 条作品零 hashtag（点评见 `E:\video\小智AI\输出\ep0_douyin_review_v1.md`）
- 剪映同款封面字体未替换（用户嫌 `msyhbd.ttc` 不好看）
