waner667/esp32-c6-gimbal-tracker/(commit log)

2026-10-24 ESP32-C6 两轴云台：人脸追踪闭环 + LEDC 固件 + 全套文档
    闭环：USB 摄像头坐云台上，PC 端 OpenCV(YuNet) 检测人脸 → 算偏移 →
    比例控制+死区 → 串口发角度 → SG90 追人。2026-10-24 闭环跑通。
    固件：gimbal_firmware_ledc 为必烧版（PWM 走底层 driver/ledc.h，
    绕开 ESP32Servo 在 C6 上 attach 成功但无波形的坑）；ESP32Servo 版
    仅存档勿烧。
    踩坑沉淀（详见 README 与 wiring-guide.md）：
    - 舵机必须外部 5V 独立供电，USB 只供板子，否则回显全正常但舵机不动
    - 跑脚本必须用全路径受管解释器，裸 python 缺 pyserial 会静默降级仅检测模式
    - HUD 画面文本必须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
2026-10-25 docs: add architecture diagrams (closed-loop + PC software toolchain)
    - architecture-closed-loop.svg/png: system-level closed-loop architecture
    (camera -> YuNet -> offset calc -> COM10 -> C6 firmware PWM -> SG90)
    - pc-software-toolchain.svg/png: tracker.py module layout + preflight/test_servolink
    - 2x PNG rendered via headless Edge; SVG sources kept for future edits
